cwoodall/led-watch/hardware/led-watch.pdf

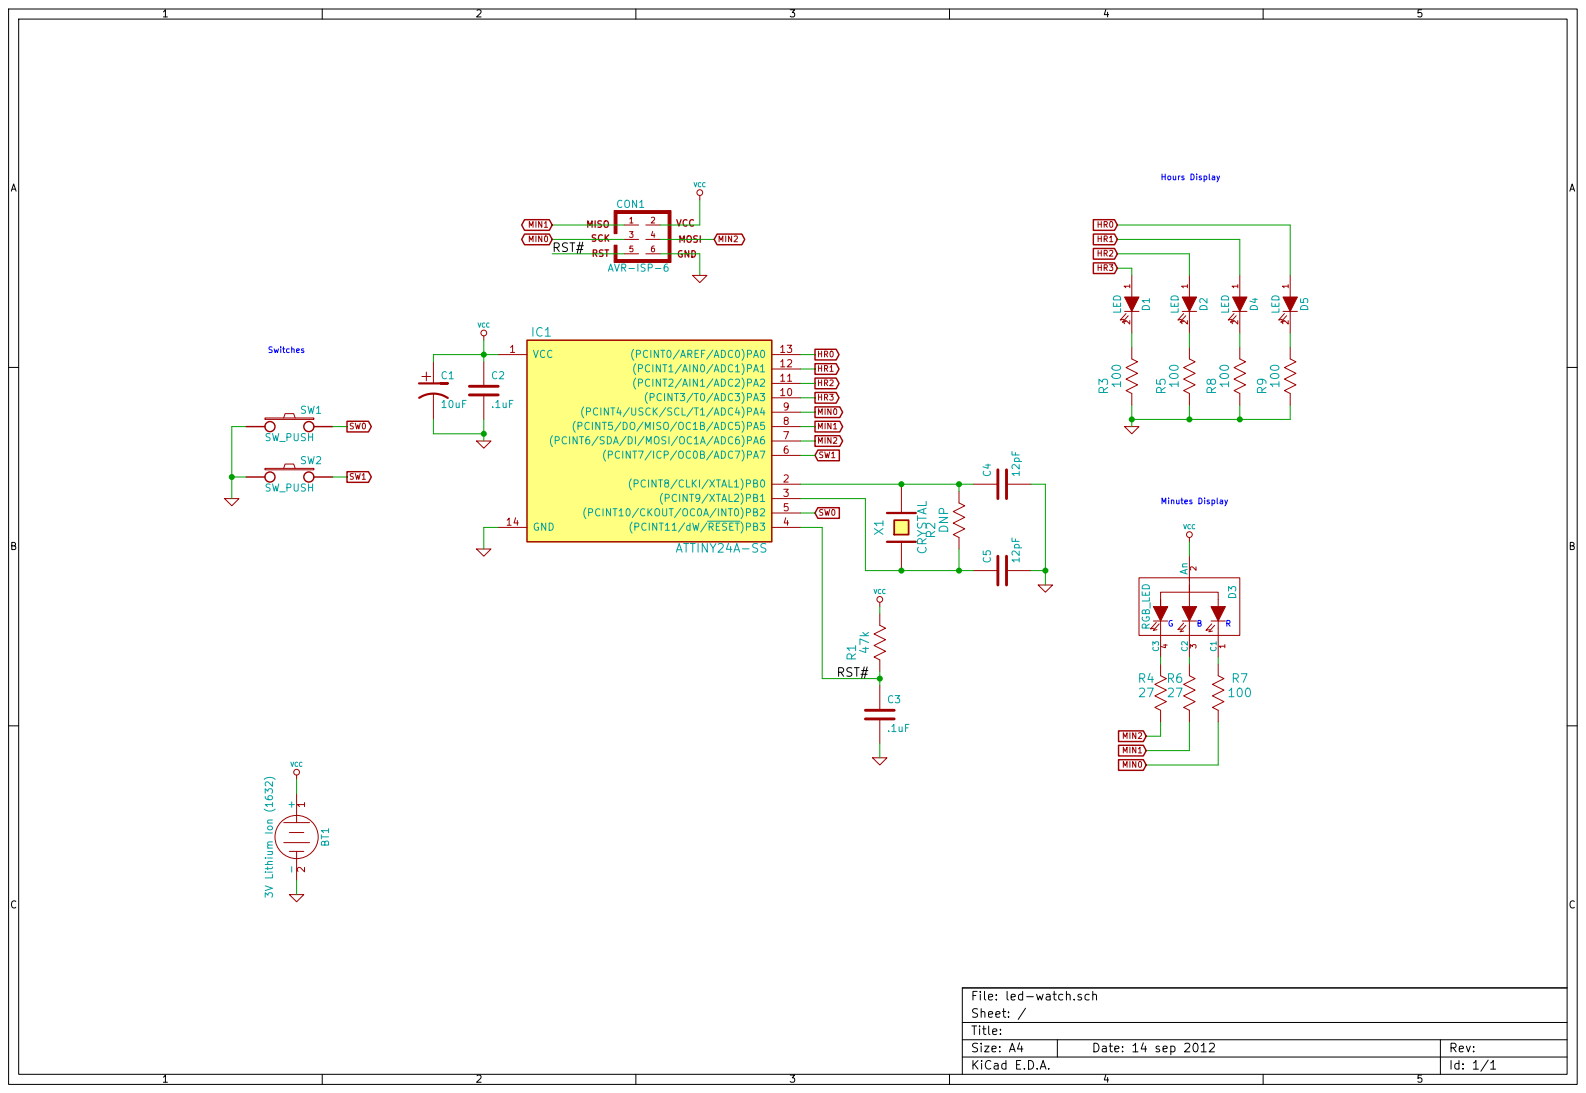
[picture p1: page 1]

Id: 1/1 Title: File: led-watch.sch Sheet: /
