cwoodall/led-watch/hardware/led-watch.sch

## KiCad design hardware/led-watch.sch (2012-10-07)

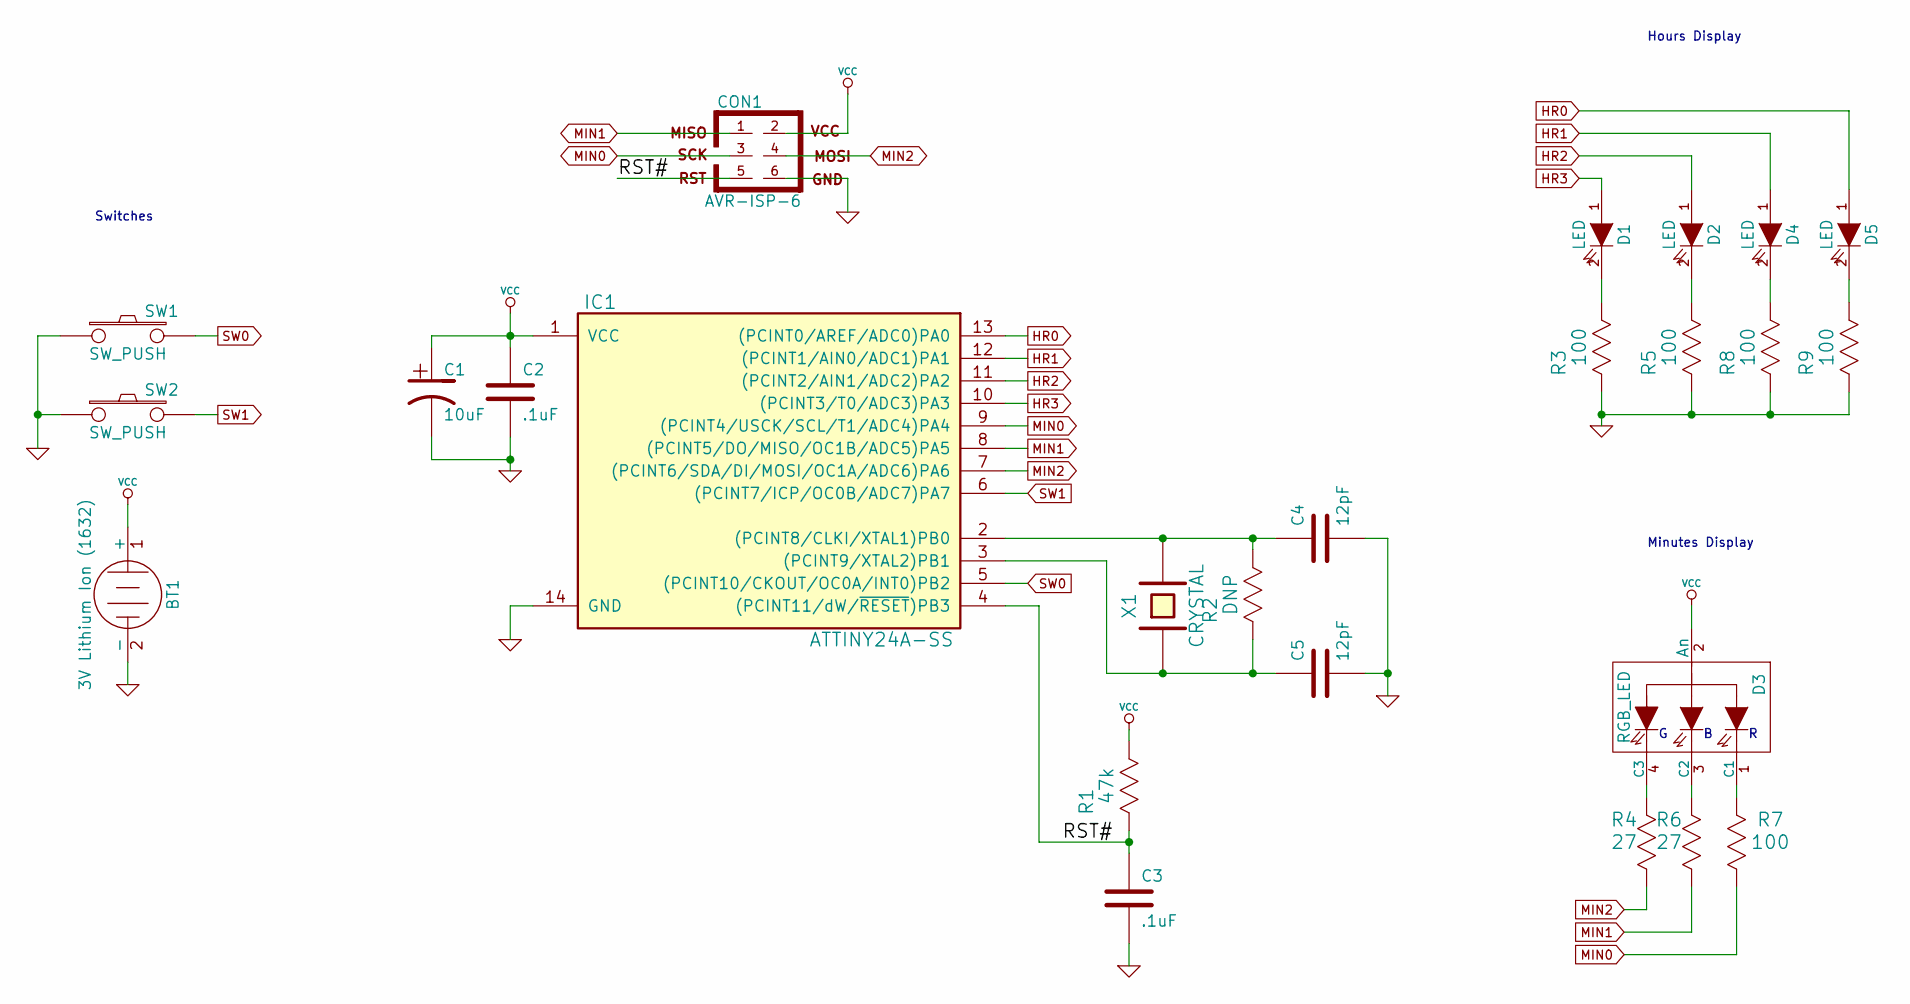
[picture p2: schematic led-watch.sch]

Parts:
BT1: 3V Lithium Ion (1632); BATTERY_CR1632_RETAINER
C1: 10uF; SM0805
C2, C3: .1uF; SM0805
C4, C5: 12pF; SM0805
CON1: AVR-ISP-6; pin_array_3x2
D1, D2, D4, D5: LED; SM0805
D3: RGB_LED; RGB_LED_HSMF-C114
IC1: ATTINY24A-SS; SO14E
R1: 47k; SM0805
R2: DNP; SM0805
R3, R5, R7, R8, R9: 100; SM0805
R4, R6: 27; SM0805
SW1, SW2: SW_PUSH; SWITCH_EVQP7C
X1: CRYSTAL; XTAL_32.768kHz_CMJ206T

Connections:
GND: BT1.2 (-), C1.2, C2.2, C3.2, C4.2, C5.2, CON1.6, IC1.14 (GND), R3.1, R5.1, R8.1, R9.1, SW1.1, SW2.1
HR0: D5.1 (A), IC1.13 ((PCINT0/AREF/ADC0)PA0)
HR1: D4.1 (A), IC1.12 ((PCINT1/AIN0/ADC1)PA1)
HR2: D2.1 (A), IC1.11 ((PCINT2/AIN1/ADC2)PA2)
HR3: D1.1 (A), IC1.10 ((PCINT3/T0/ADC3)PA3)
MIN0: CON1.3, IC1.9 ((PCINT4/USCK/SCL/T1/ADC4)PA4), R7.1
MIN1: CON1.1, IC1.8 ((PCINT5/DO/MISO/OC1B/ADC5)PA5), R6.1
MIN2: CON1.4, IC1.7 ((PCINT6/SDA/DI/MOSI/OC1A/ADC6)PA6), R4.1
unnamed: C4.1, IC1.2 ((PCINT8/CLKI/XTAL1)PB0), R2.2, X1.2
unnamed: C5.1, IC1.3 ((PCINT9/XTAL2)PB1), R2.1, X1.1
unnamed: D1.2 (K), R3.2
unnamed: D2.2 (K), R5.2
unnamed: D3.1 (C1), R7.2
unnamed: D3.3 (C2), R6.2
unnamed: D3.4 (C3), R4.2
unnamed: D4.2 (K), R8.2
unnamed: D5.2 (K), R9.2
RST#: C3.1, CON1.5, IC1.4 ((PCINT11/dW/~RESET~)PB3), R1.1
SW0: IC1.5 ((PCINT10/CKOUT/OC0A/INT0)PB2), SW1.2
SW1: IC1.6 ((PCINT7/ICP/OC0B/ADC7)PA7), SW2.2
VCC: BT1.1 (+), C1.1, C2.1, CON1.2, D3.2 (An), IC1.1 (VCC), R1.2

Notes on the sheet:
Hours Display
Minutes Display
Switches
