cwoodall/led-watch/(commit log)

2012-09-09 Finished board layout
    [led-watch.brd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]
2012-09-10 small fixes
    [led-watch.brd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]
2012-09-14 Minor fixes
    [led-watch.brd, led-watch.csv]
2012-09-15 Changed to new RGB LED footprint for D3. Need to fix some retarded routing decisions.
    [led-watch.brd, led-watch.sch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]
2012-09-15 Finished layout. Submitting to OSHPark
    [led-watch.brd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]
2012-09-15 Ordered LED Watches. Can't Wait.
    [led-watch.brd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]
2012-10-07 LED Watch Rev. A complete. Need to make fixes
    [led-watch.sch]
2012-11-10 oops... fixed that versioning error
    [led-watch.c]
